bemcgarvey/AutoDischarger/README.md

# AutoDischarger 
 
A cell discharger/balancer for lipo batteries.  
PCB can be populated for 3S - 6S batteries.  
  
Operates in one of two modes: (push button switches modes)
1. Balance cells by discharging down to the lowest cell (starting mode) 
2. Storage mode - discharge all cells to 3.85V
