bemcgarvey/AutoDischarger/schematic/AutoDischarger/AutoDischargerBOM.xlsx

Source: | AutoDischarger
Component Count: | 78
Ref | Qnty | Value | Footprint
C1, | 1 | 1 uF | Capacitor_SMD:C_0603_1608Metric
C2, | 1 | 10 uF | Capacitor_SMD:C_0603_1608Metric
C3, C4, C5, C6, | 3 | 100nF | Capacitor_SMD:C_0603_1608Metric
D1, | 1 | LED | LED_SMD:LED_0603_1608Metric
IC1, | 1 | AP7375-50W5-7 | SOT95P285X140-5N
IC2, | 1 | PIC18F15Q40-I_SS | SamacSys_Parts:SOP65P780X200-20N
IC3, IC4, IC5, | 3 | TLV9102SIDGSR | SamacSys_Parts:SOP50P490X110-10N
J1, | 1 | ICSP | Connector_PinHeader_2.54mm:PinHeader_1x05_P2.54mm_Vertical
J2, | 1 | Balance Lead | Connector_JST:JST_XH_B7B-XH-A_1x07_P2.50mm_Vertical
JP1, JP2, JP3, JP4, | 4 | SolderJumper_3_Open | Jumper:SolderJumper-3_P1.3mm_Open_RoundedPad1.0x1.5mm_NumberLabels
Q1, Q2, Q3, Q4, Q5, Q6, Q7, Q8, Q9, Q10, Q11, | 11 | 2N7002_HAMR | Package_TO_SOT_SMD:SOT-23
R1, R32, R33, R34, R35, R36, R37, | 7 | 1K | Resistor_SMD:R_0603_1608Metric
R2, R3, R5, R6, R8, R9, R10, R12, R14, R16, R18, R20, R21, R22, R23, R24, R26, R27, R29, R30, R38, R39, R40, R41, R42, | 25 | 10M | Resistor_SMD:R_0603_1608Metric
R4, R7, R11, R13, R15, R17, R19, R25, R28, R31, | 10 | 1M | Resistor_SMD:R_0603_1608Metric
R43, R44, R45, R46, R47, R48, | 6 | 120R | Resistor_SMD:R_1206_3216Metric
R49 | 1 | 10K | Resistor_SMD:R_0603_1608Metric
S1, | 1 | PTS647SK38SMTR2LFS | SamacSys_Parts:PTS647SK38SMTR2LFS
