bemcgarvey/AutoDischarger/schematic/AutoDischarger/AutoDischarger.kicad_pcb

## KiCad design schematic/AutoDischarger/AutoDischarger.kicad_pcb (2023-02-26)

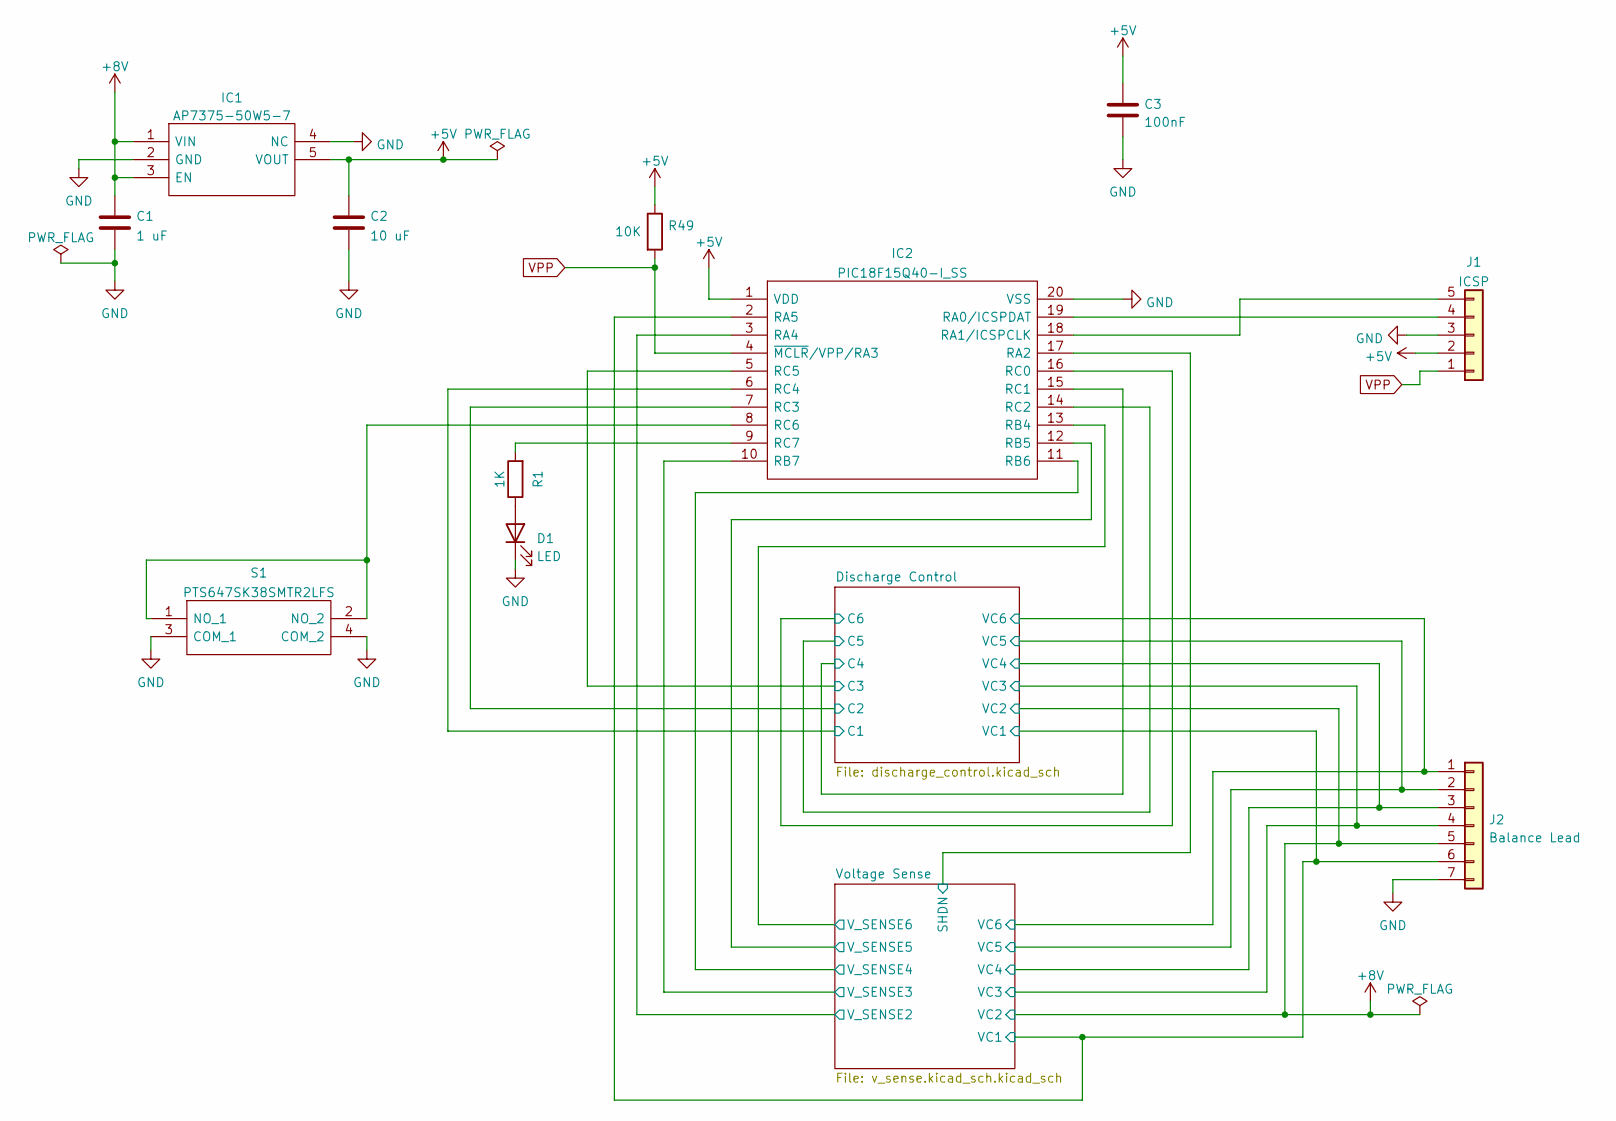
[picture p1: schematic AutoDischarger.kicad_sch, Lipo Auto Discharger/Balancer]

Parts:
C1: 1 uF; C_0603_1608Metric
C2: 10 uF; C_0603_1608Metric
C3: 100nF; C_0603_1608Metric
D1: LED; LED_0603_1608Metric
IC1: AP7375-50W5-7; SOT95P285X140-5N; Mouser Part Number 621-AP7375-50W5-7
IC2: PIC18F15Q40-I_SS; SOP65P780X200-20N; Mouser Part Number 579-PIC18F15Q40-I/SS
J1: ICSP; PinHeader_1x05_P2.54mm_Vertical
J2: Balance Lead; JST_XH_B7B-XH-A_1x07_P2.50mm_Vertical
R1: 1K; R_0603_1608Metric
R49: 10K; R_0603_1608Metric
S1: PTS647SK38SMTR2LFS; Mouser Part Number 611-PTS647SK38SMTR2L

Connections:
+5V: C2.1, C3.1, IC1.5 (VOUT), IC2.1 (VDD), J1.2, R49.1
+8V: C1.1, IC1.1 (VIN), IC1.3 (EN), J2.5; also elsewhere on the board
/Discharge Control/C1: IC2.6 (RC4); also elsewhere on the board
/Discharge Control/C2: IC2.7 (RC3); also elsewhere on the board
/Discharge Control/C3: IC2.5 (RC5); also elsewhere on the board
/Discharge Control/C4: IC2.15 (RC1); also elsewhere on the board
/Discharge Control/C5: IC2.14 (RC2); also elsewhere on the board
/Discharge Control/C6: IC2.16 (RC0); also elsewhere on the board
/Discharge Control/VC1: IC2.2 (RA5), J2.6; also elsewhere on the board
/Discharge Control/VC3: J2.4; also elsewhere on the board
/Discharge Control/VC4: J2.3; also elsewhere on the board
/Discharge Control/VC5: J2.2; also elsewhere on the board
/Discharge Control/VC6: J2.1; also elsewhere on the board
/Voltage Sense/SHDN: IC2.17 (RA2); also elsewhere on the board
/Voltage Sense/V_SENSE2: IC2.3 (RA4); also elsewhere on the board
/Voltage Sense/V_SENSE3: IC2.10 (RB7); also elsewhere on the board
/Voltage Sense/V_SENSE4: IC2.11 (RB6); also elsewhere on the board
/Voltage Sense/V_SENSE5: IC2.12 (RB5); also elsewhere on the board
/Voltage Sense/V_SENSE6: IC2.13 (RB4); also elsewhere on the board
GND: C1.2, C2.2, C3.2, D1.1 (K), IC1.2 (GND), IC1.4 (NC), IC2.20 (VSS), J1.3, J2.7, S1.3 (COM_1), S1.4 (COM_2); also elsewhere on the board
unnamed: D1.2 (A), R1.1
unnamed: IC2.8 (RC6), S1.1 (NO_1), S1.2 (NO_2)
unnamed: IC2.9 (RC7), R1.2
unnamed: IC2.18 (RA1/ICSPCLK), J1.5
unnamed: IC2.19 (RA0/ICSPDAT), J1.4
VPP: IC2.4 (~MCLR/VPP/RA3), J1.1, R49.2

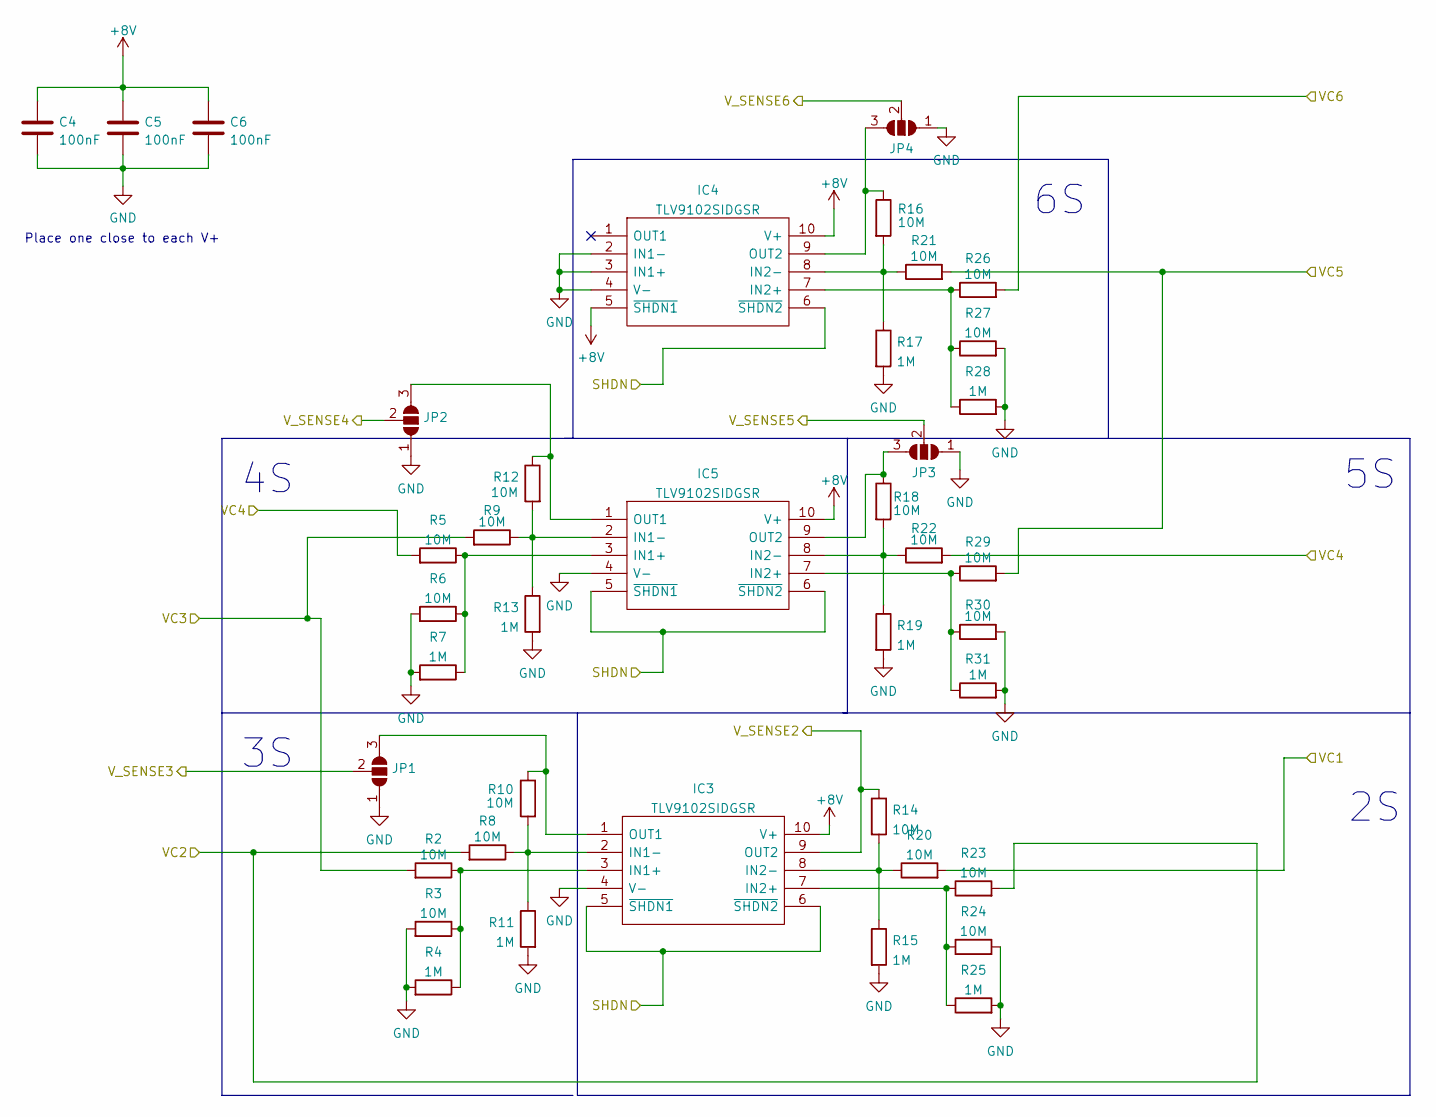
[picture p2: schematic v_sense.kicad_sch.kicad_sch, Lipo Auto Discharger/Balancer]

Parts:
C4, C5, C6: 100nF; C_0603_1608Metric
IC3, IC4, IC5: TLV9102SIDGSR; SOP50P490X110-10N; Mouser Part Number 595-TLV9102SIDGSR
JP1, JP2, JP3, JP4: SolderJumper_3_Open; SolderJumper-3_P1.3mm_Open_RoundedPad1.0x1.5mm_NumberLabels
R2, R3, R5, R6, R8, R9, R10, R12, R14, R16, R18, R20, R21, R22, R23, R24, R26, R27, R29, R30: 10M; R_0603_1608Metric
R4, R7, R11, R13, R15, R17, R19, R25, R28, R31: 1M; R_0603_1608Metric

Connections:
+8V: C4.1, C5.1, C6.1, IC3.10 (V+), IC4.5 (~SHDN1), IC4.10 (V+), IC5.10 (V+), R8.2, R23.2; also elsewhere on the board
/Discharge Control/VC1: R20.2; also elsewhere on the board
/Discharge Control/VC3: R2.2, R9.2; also elsewhere on the board
/Discharge Control/VC4: R5.2, R22.2; also elsewhere on the board
/Discharge Control/VC5: R21.2, R29.2; also elsewhere on the board
/Discharge Control/VC6: R26.2; also elsewhere on the board
/Voltage Sense/SHDN: IC3.5 (~SHDN1), IC3.6 (~SHDN2), IC4.6 (~SHDN2), IC5.5 (~SHDN1), IC5.6 (~SHDN2); also elsewhere on the board
/Voltage Sense/V_SENSE2: IC3.9 (OUT2), R14.1; also elsewhere on the board
/Voltage Sense/V_SENSE3: JP1.2 (C); also elsewhere on the board
/Voltage Sense/V_SENSE4: JP2.2 (C); also elsewhere on the board
/Voltage Sense/V_SENSE5: JP3.2 (C); also elsewhere on the board
/Voltage Sense/V_SENSE6: JP4.2 (C); also elsewhere on the board
GND: C4.2, C5.2, C6.2, IC3.4 (V-), IC4.2 (IN1-), IC4.3 (IN1+), IC4.4 (V-), IC5.4 (V-), JP1.1 (A), JP2.1 (A), JP3.1 (A), JP4.1 (A), R3.2, R4.2, R6.2, R7.2, R11.2, R13.2, R15.2, R17.2, R19.2, R24.2, R25.2, R27.2, R28.2, R30.2, R31.2; also elsewhere on the board
unnamed: IC3.1 (OUT1), JP1.3 (B), R10.1
unnamed: IC3.2 (IN1-), R8.1, R10.2, R11.1
unnamed: IC3.3 (IN1+), R2.1, R3.1, R4.1
unnamed: IC3.7 (IN2+), R23.1, R24.1, R25.1
unnamed: IC3.8 (IN2-), R14.2, R15.1, R20.1
unnamed: IC4.7 (IN2+), R26.1, R27.1, R28.1
unnamed: IC4.8 (IN2-), R16.2, R17.1, R21.1
unnamed: IC4.9 (OUT2), JP4.3 (B), R16.1
unnamed: IC5.1 (OUT1), JP2.3 (B), R12.1
unnamed: IC5.2 (IN1-), R9.1, R12.2, R13.1
unnamed: IC5.3 (IN1+), R5.1, R6.1, R7.1
unnamed: IC5.7 (IN2+), R29.1, R30.1, R31.1
unnamed: IC5.8 (IN2-), R18.2, R19.1, R22.1
unnamed: IC5.9 (OUT2), JP3.3 (B), R18.1

Notes on the sheet:
Place one close to each V+

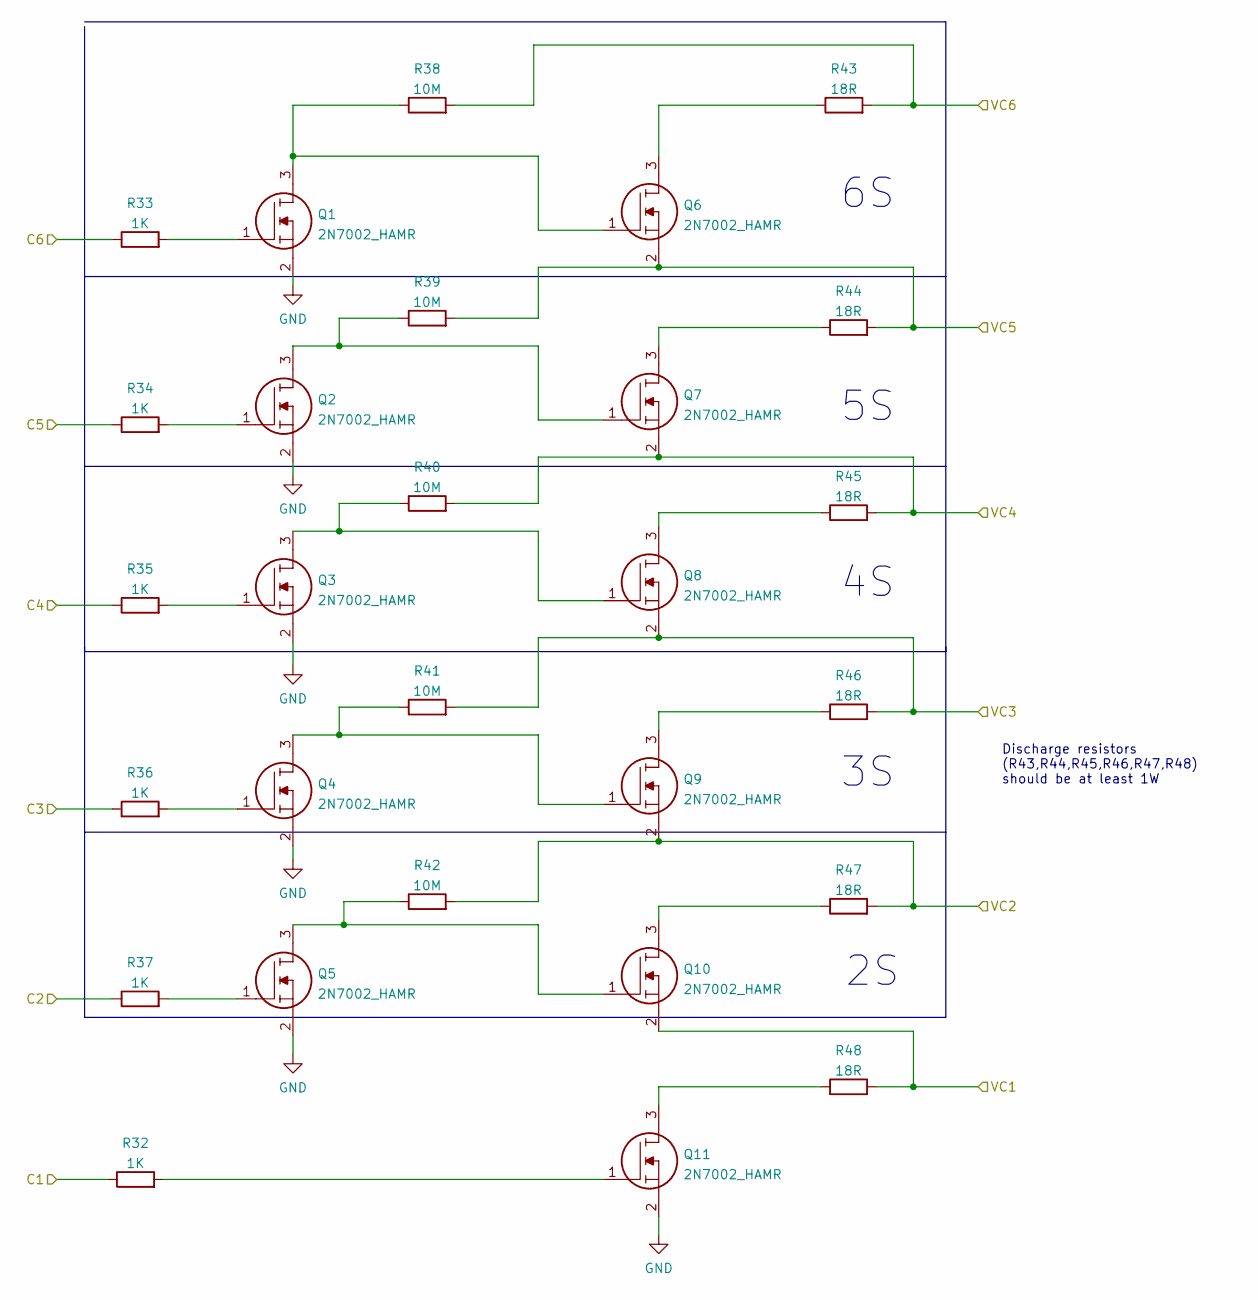
[picture p3: schematic discharge_control.kicad_sch, Lipo Auto Discharger/Balancer]

Parts:
Q1, Q2, Q3, Q4, Q5, Q6, Q7, Q8, Q9, Q10, Q11: 2N7002_HAMR; SOT-23; Mouser Part Number 771-2N7002/HAMR
R32, R33, R34, R35, R36, R37: 1K; R_0603_1608Metric
R38, R39, R40, R41, R42: 10M; R_0603_1608Metric
R43, R44, R45, R46, R47, R48: 18R; R_2512_6332Metric

Connections:
+8V: Q9.2, R42.2, R47.2; also elsewhere on the board
/Discharge Control/C1: R32.1; also elsewhere on the board
/Discharge Control/C2: R37.1; also elsewhere on the board
/Discharge Control/C3: R36.1; also elsewhere on the board
/Discharge Control/C4: R35.1; also elsewhere on the board
/Discharge Control/C5: R34.1; also elsewhere on the board
/Discharge Control/C6: R33.1; also elsewhere on the board
/Discharge Control/VC1: Q10.2, R48.2; also elsewhere on the board
/Discharge Control/VC3: Q8.2, R41.2, R46.2; also elsewhere on the board
/Discharge Control/VC4: Q7.2, R40.2, R45.2; also elsewhere on the board
/Discharge Control/VC5: Q6.2, R39.2, R44.2; also elsewhere on the board
/Discharge Control/VC6: R38.2, R43.2; also elsewhere on the board
GND: Q1.2, Q2.2, Q3.2, Q4.2, Q5.2, Q11.2; also elsewhere on the board
unnamed: Q1.1, R33.2
unnamed: Q1.3, Q6.1, R38.1
unnamed: Q2.1, R34.2
unnamed: Q2.3, Q7.1, R39.1
unnamed: Q3.1, R35.2
unnamed: Q3.3, Q8.1, R40.1
unnamed: Q4.1, R36.2
unnamed: Q4.3, Q9.1, R41.1
unnamed: Q5.1, R37.2
unnamed: Q6.3, R43.1
unnamed: Q7.3, R44.1
unnamed: Q8.3, R45.1
unnamed: Q9.3, R46.1
unnamed: Q5.3, Q10.1, R42.1
unnamed: Q10.3, R47.1
unnamed: Q11.1, R32.2
unnamed: Q11.3, R48.1

Notes on the sheet:
Discharge resistors (R43,R44,R45,R46,R47,R48) should be at least 1W

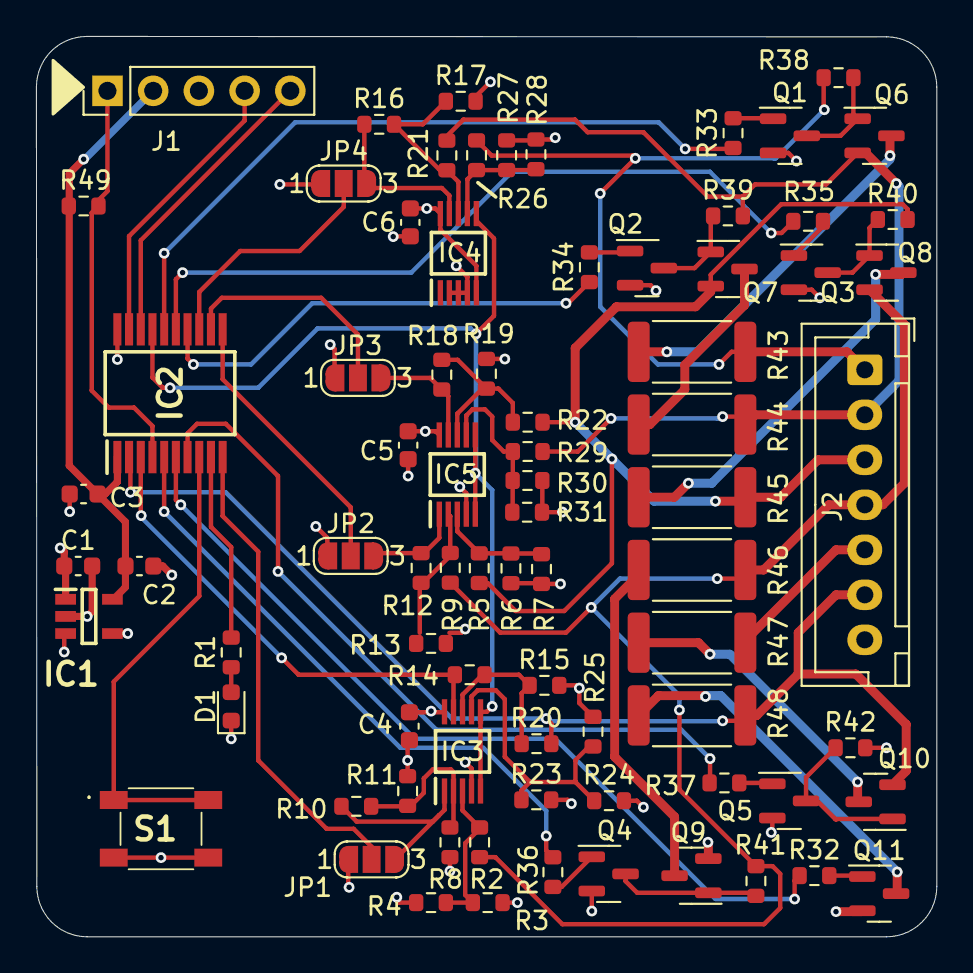
[picture p4: board AutoDischarger.kicad_pcb from above]

Board: 4 copper layers, 50.0 x 50.0 mm, 79 parts (0 on the bottom side), 57 nets.
