bemcgarvey/AutoDischarger/(commit log)

2022-11-06 Initial KiCad project
    [AutoDischarger.kicad_pcb, AutoDischarger.kicad_sch]
2022-11-06 Initial schematic
    [AutoDischarger.kicad_sch, discharge_control.kicad_sch, v_sense.kicad_sch.kicad_sch]
2022-11-07 Some schematic fixes and assigned footprints.
    [AutoDischarger.kicad_sch, discharge_control.kicad_sch, v_sense.kicad_sch.kicad_sch]
2022-11-07 Some schematic and footprint fixes
    [AutoDischarger.kicad_sch, discharge_control.kicad_sch]
2022-11-08 Initial pcb - parts placed
    [AutoDischarger.kicad_pcb]
2022-11-22 Initial pcb layout
    [AutoDischarger.kicad_pcb, AutoDischarger.kicad_sch]
2022-11-26 Generated BOM
    [AutoDischargerBOM.xlsx]
2022-11-26 PCB tweaks
    [AutoDischarger.kicad_pcb, AutoDischarger.kicad_sch, v_sense.kicad_sch.kicad_sch]
2023-01-26 Changed 5V regulator
    [AutoDischarger.kicad_pcb, AutoDischarger.kicad_sch, v_sense.kicad_sch.kicad_sch]
2023-01-26 Updated BOM and fixed some labels
    [AutoDischarger.kicad_sch, AutoDischargerBOM.xlsx, discharge_control.kicad_sch, v_sense.kicad_sch.kicad_sch]
2023-01-26 Added pullup to MCLR
    [AutoDischarger.kicad_pcb, AutoDischarger.kicad_sch, AutoDischargerBOM.xlsx]
2023-01-27 Minor pcb tweaks
    [AutoDischarger.kicad_pcb]
2023-02-02 Generated gerbers
    [AutoDischarger-B_Cu.gbl, AutoDischarger-B_Mask.gbs, AutoDischarger-B_Silkscreen.gbo, AutoDischarger-Edge_Cuts.gm1, AutoDischarger-F_Cu.gtl, AutoDischarger-F_Mask.gts, AutoDischarger-F_Silkscreen.gto, AutoDischarger-NPTH.drl]
2023-02-25 Updated for 18R 1W 2512 resistors
    [AutoDischarger.kicad_pcb, AutoDischarger.kicad_sch, discharge_control.kicad_sch]
2023-02-25 Added WDT and improved low power
2023-02-26 Some improvements and new gerbers
    [AutoDischarger-B_Cu.gbl, AutoDischarger-B_Mask.gbs, AutoDischarger-B_Silkscreen.gbo, AutoDischarger-Edge_Cuts.gm1, AutoDischarger-F_Cu.gtl, AutoDischarger-F_Mask.gts, AutoDischarger-F_Silkscreen.gto, AutoDischarger-NPTH.drl]
2023-03-13 New gerbers V1.1
    [AutoDischarger-B_Cu.gbl, AutoDischarger-B_Mask.gbs, AutoDischarger-B_Silkscreen.gbo, AutoDischarger-Edge_Cuts.gm1, AutoDischarger-F_Cu.gtl, AutoDischarger-F_Mask.gts, AutoDischarger-F_Silkscreen.gto, AutoDischarger-NPTH.drl]
2023-04-23 Adjusted discharge duty cycle to 50%
    Keeps temperature reasonable
